Pai-88/emg-robotic-hand/docs/electronics_setup.html

# EMG → Robotic Hand · Electronic Setup

Dual-channel surface EMG · ESP32 acquires at 1 kHz · UDP/WiFi → Pi 5 inference → PCA9685 → 5-finger servo hand

3.3 V power

Ground

CH 1 · flexor signal

CH 2 · extensor signal

Leads-off (digital)

WiFi (UDP)

I²C

PWM (servo)

AD8232 #1 (flexor) → ESP32

AD8232 pin | ESP32 pin | Signal
3.3V | 3V3 | power
GND | GND | ground
OUTPUT | GPIO 34 | analog (flexor)
LO+ | GPIO 25 | leads-off (+)
LO− | GPIO 27 | leads-off (−)
RA | — | flexor electrode +
LA | — | flexor electrode −
RL | — | reference (shared with #2)

AD8232 #2 (extensor) → ESP32

AD8232 pin | ESP32 pin | Signal
3.3V | 3V3 | power (shared)
GND | GND | ground (shared)
OUTPUT | GPIO 35 | analog (extensor)
LO+ | GPIO 26 | leads-off (+)
LO− | GPIO 32 | leads-off (−)
RA | — | extensor electrode +
LA | — | extensor electrode −
RL | — | reference (same electrode as #1)

⚠ Servo power: Drive the PCA9685's V+ from a separate 5–6 V supply (e.g. UBEC, bench PSU, or fresh 4× AA pack), with its GND tied to the Pi's GND. Do not power servos from the Pi's 5 V rail — typical hobby-servo stall current (~1 A each, ×5) will brown out the Pi and risk corrupting the SD card.

Pin assignments mirror esp32_emg_streamer.ino (the active dual-channel UDP firmware). Edit it (or this diagram) in lockstep if you reassign pins. Sampling: 1 kHz × 2 ch, packet size 48 bytes.
