Pai-88/emg-robotic-hand/kicad/emg_frontend.pdf

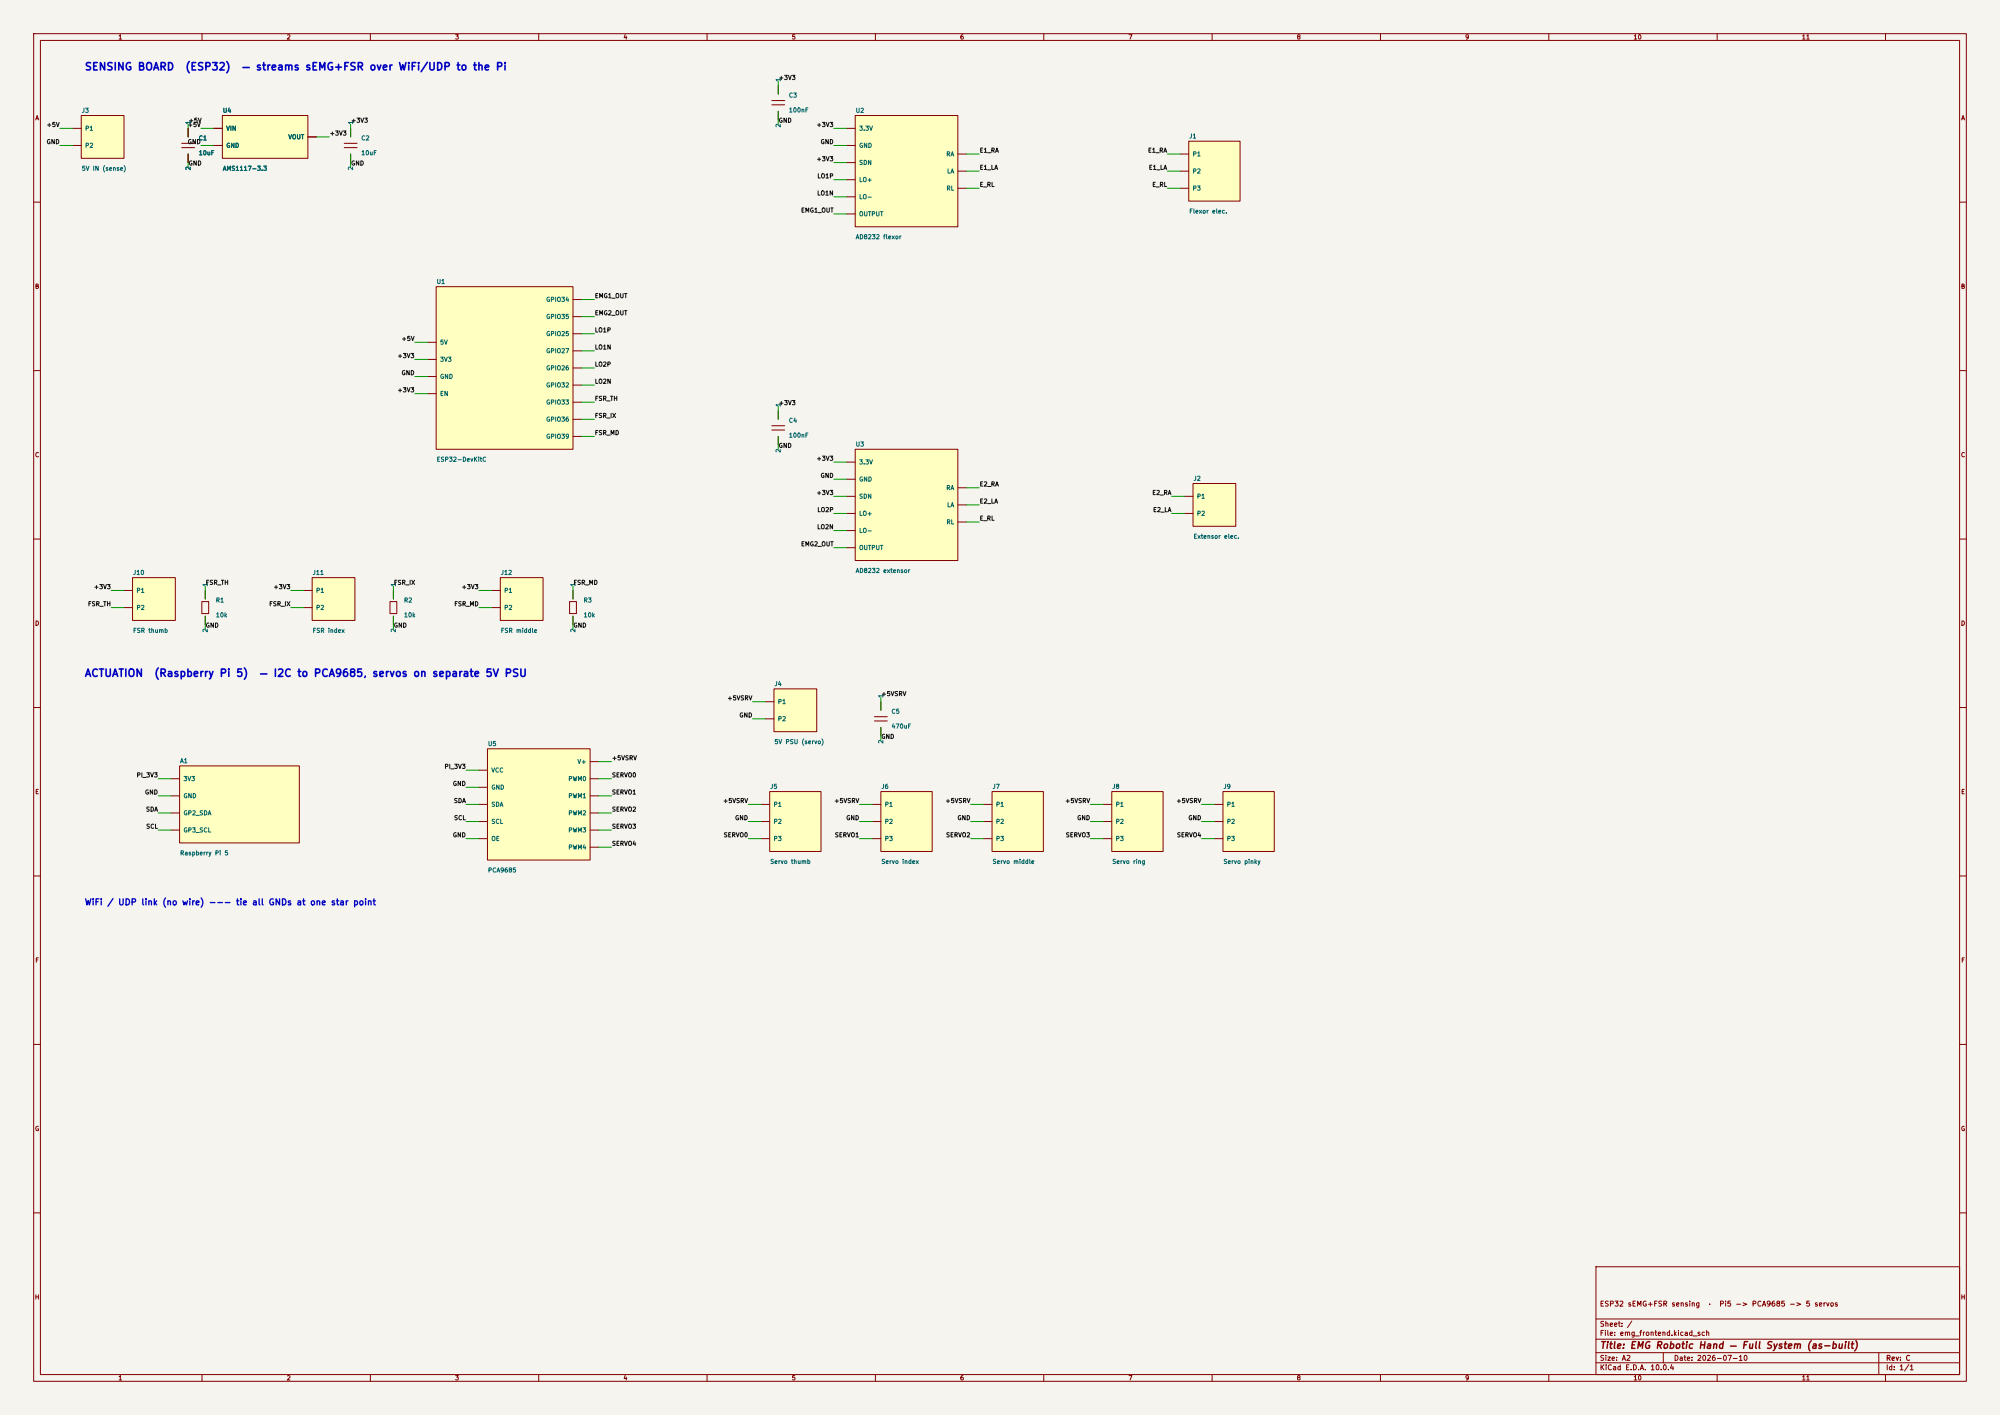
[picture p1: page 1]

SENSING BOARD (ESP32) — streams sEMG+FSR over WiFi/UDP to the Pi C1

FSR_IX ACTUATION (Raspberry Pi 5) — I2C to PCA9685, servos on separate 5V PSU

WiFi / UDP link (no wire) --- tie all GNDs at one star point

ESP32 sEMG+FSR sensing · Pi5 -> PCA9685 -> 5 servos

Sheet: /
File: emg_frontend.kicad_sch
Title: EMG Robotic Hand — Full System (as-built)

Size: A2 | Rev: C
KiCad E.D.A. 10.0.4 | Id: 1/1
