Pai-88/emg-robotic-hand/kicad/emg_frontend.kicad_sch

## KiCad design kicad/emg_frontend.kicad_sch (2026-07-14)

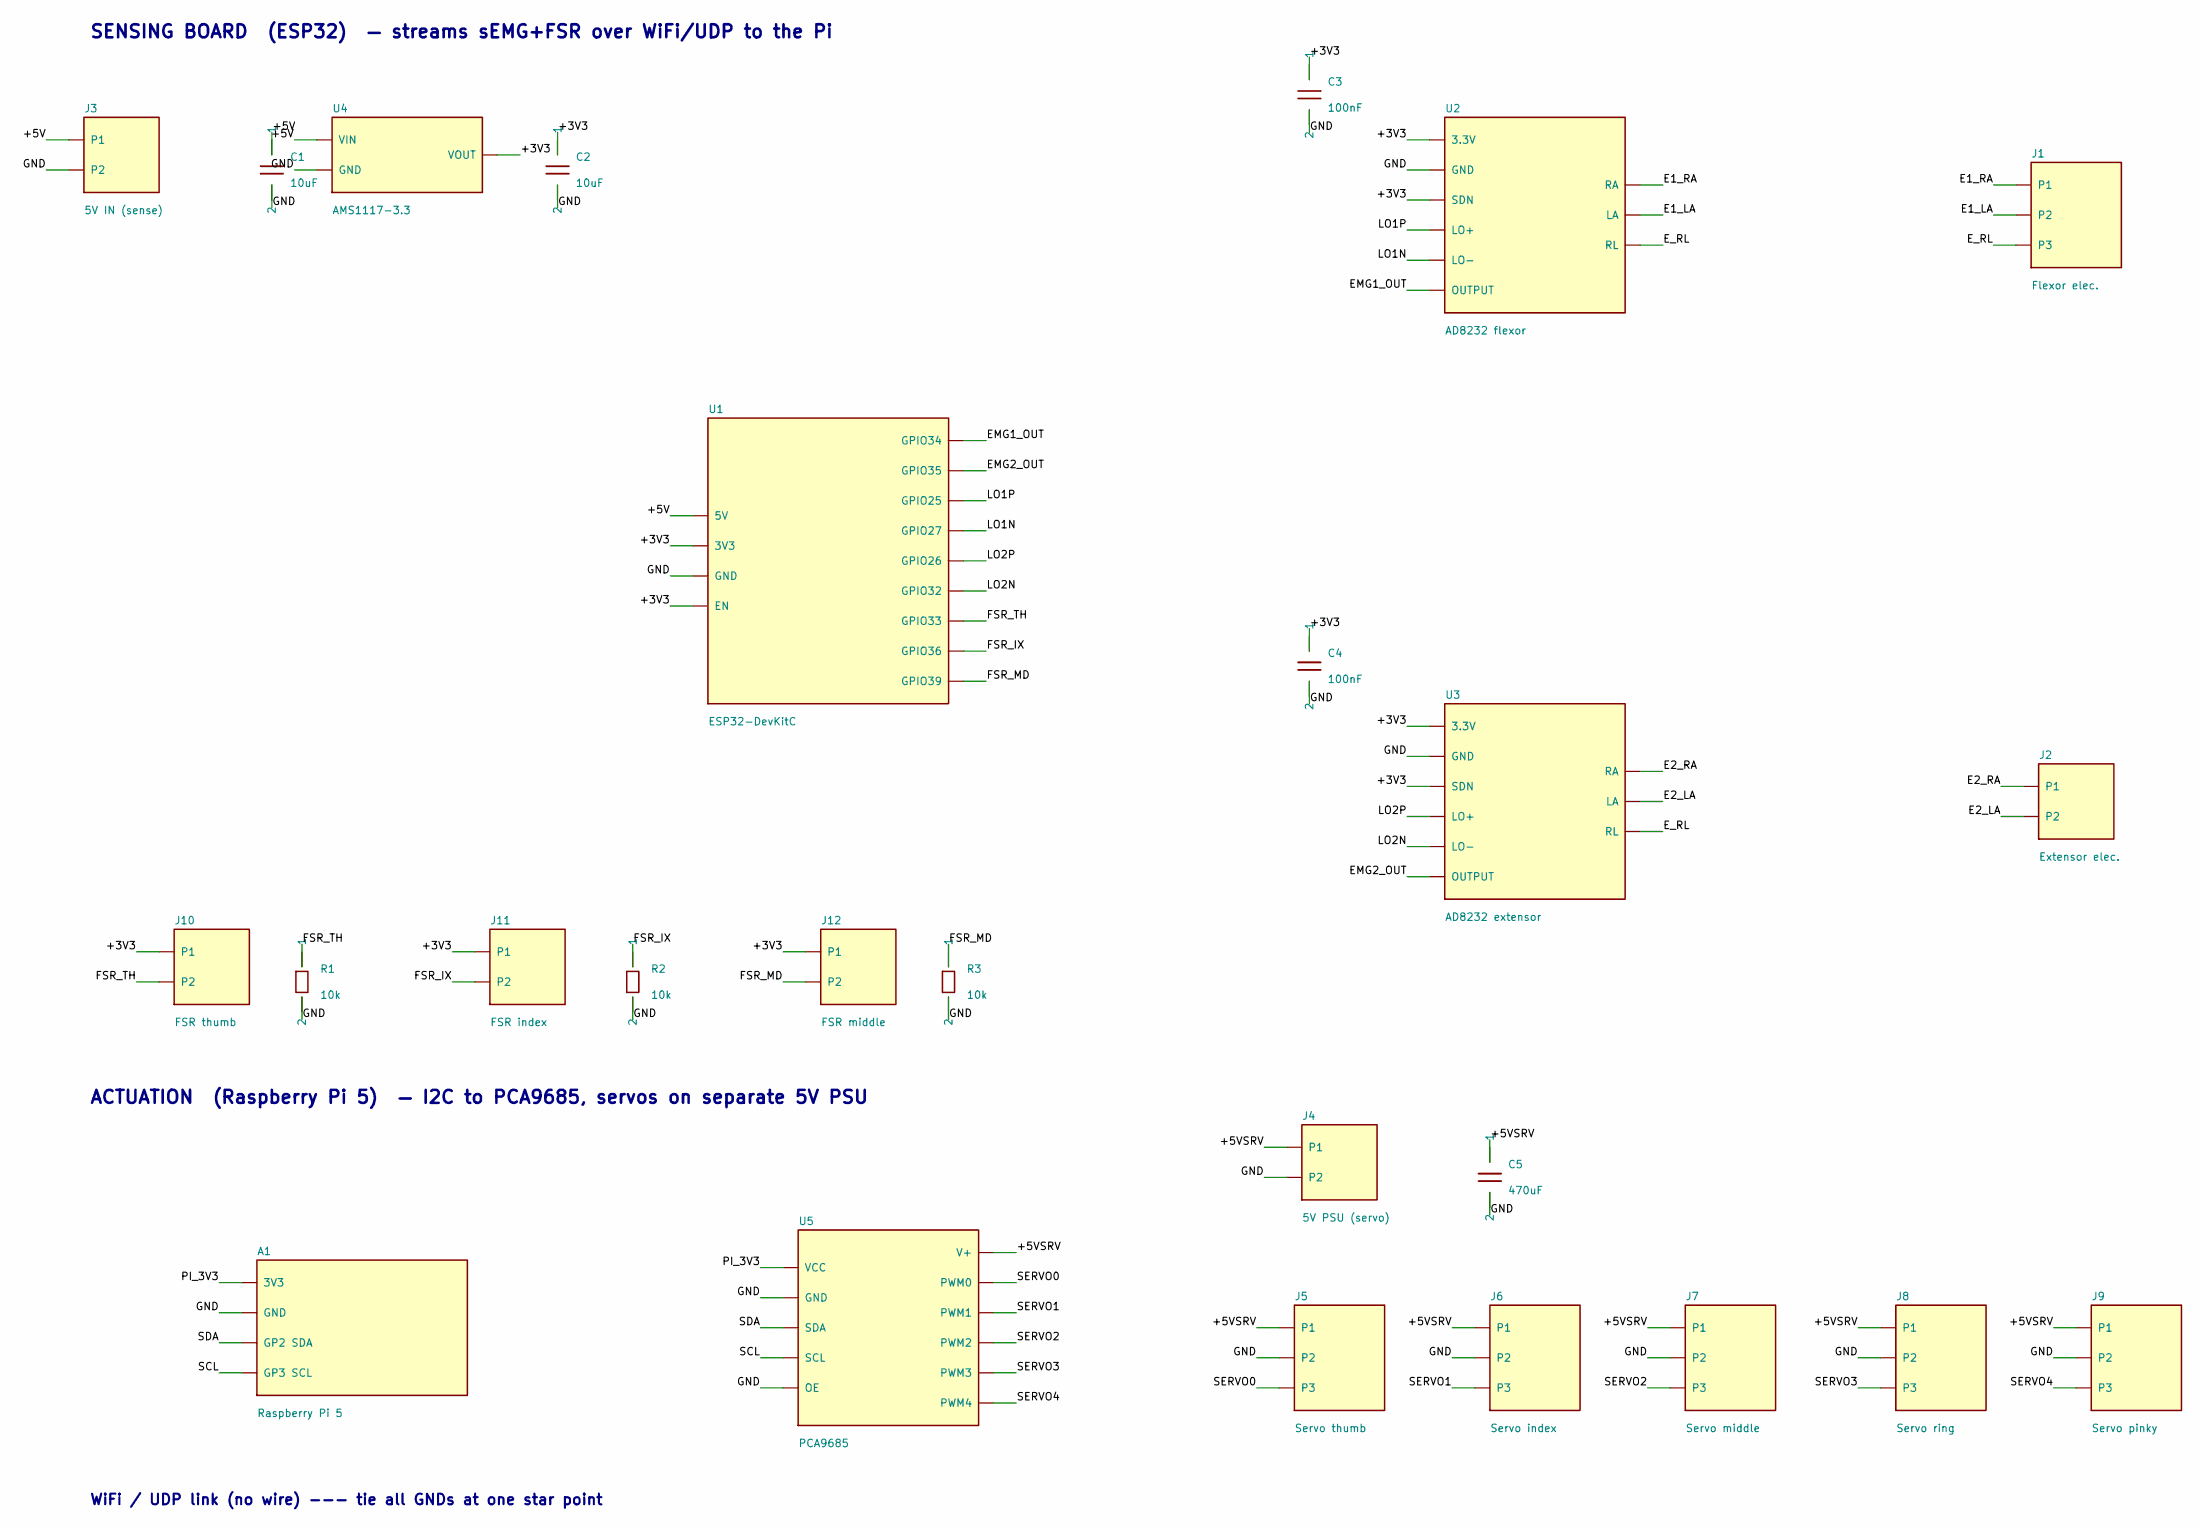
[picture p2: schematic emg_frontend.kicad_sch]

Parts:
A1: Raspberry Pi 5; PinHeader_2x20_P2.54mm_Vertical
C1, C2: 10uF; C_1206_3216Metric
C3, C4: 100nF; C_0805_2012Metric
C5: 470uF; CP_Radial_D8.0mm_P3.50mm
J1: Flexor elec.; PinHeader_1x03_P2.54mm_Vertical
J2: Extensor elec.; PinHeader_1x02_P2.54mm_Vertical
J3: 5V IN (sense); TerminalBlock_MaiXu_MX126-5.0-02P_1x02_P5.00mm
J4: 5V PSU (servo); TerminalBlock_MaiXu_MX126-5.0-02P_1x02_P5.00mm
J5: Servo thumb; PinHeader_1x03_P2.54mm_Vertical
J6: Servo index; PinHeader_1x03_P2.54mm_Vertical
J7: Servo middle; PinHeader_1x03_P2.54mm_Vertical
J8: Servo ring; PinHeader_1x03_P2.54mm_Vertical
J9: Servo pinky; PinHeader_1x03_P2.54mm_Vertical
J10: FSR thumb; PinHeader_1x02_P2.54mm_Vertical
J11: FSR index; PinHeader_1x02_P2.54mm_Vertical
J12: FSR middle; PinHeader_1x02_P2.54mm_Vertical
R1, R2, R3: 10k; R_0805_2012Metric
U1: ESP32-DevKitC; PinHeader_2x19_P2.54mm_Vertical
U2: AD8232 flexor; PinHeader_1x10_P2.54mm_Vertical
U3: AD8232 extensor; PinHeader_1x10_P2.54mm_Vertical
U4: AMS1117-3.3; SOT-223-3_TabPin2
U5: PCA9685; PinHeader_2x06_P2.54mm_Vertical

Connections:
+3V3: C2.1, C3.1, C4.1, J10.1, J11.1, J12.1, U1.2 (3V3), U1.4 (EN), U2.1 (3.3V), U2.3 (SDN), U3.1 (3.3V), U3.3 (SDN), U4.3 (VOUT)
+5V: C1.1, J3.1, U1.1 (5V), U4.1 (VIN)
+5VSRV: C5.1, J4.1, J5.1, J6.1, J7.1, J8.1, J9.1, U5.6 (V+)
E1_LA: J1.2, U2.8 (LA)
E1_RA: J1.1, U2.7 (RA)
E2_LA: J2.2, U3.8 (LA)
E2_RA: J2.1, U3.7 (RA)
EMG1_OUT: U1.5 (GPIO34), U2.6 (OUTPUT)
EMG2_OUT: U1.6 (GPIO35), U3.6 (OUTPUT)
E_RL: J1.3, U2.9 (RL), U3.9 (RL)
FSR_IX: J11.2, R2.1, U1.12 (GPIO36)
FSR_MD: J12.2, R3.1, U1.13 (GPIO39)
FSR_TH: J10.2, R1.1, U1.11 (GPIO33)
GND: A1.2 (GND), C1.2, C2.2, C3.2, C4.2, C5.2, J3.2, J4.2, J5.2, J6.2, J7.2, J8.2, J9.2, R1.2, R2.2, R3.2, U1.3 (GND), U2.2 (GND), U3.2 (GND), U4.2 (GND), U5.2 (GND), U5.5 (OE)
LO1N: U1.8 (GPIO27), U2.5 (LO-)
LO1P: U1.7 (GPIO25), U2.4 (LO+)
LO2N: U1.10 (GPIO32), U3.5 (LO-)
LO2P: U1.9 (GPIO26), U3.4 (LO+)
PI_3V3: A1.1 (3V3), U5.1 (VCC)
SCL: A1.4 (GP3 SCL), U5.4 (SCL)
SDA: A1.3 (GP2 SDA), U5.3 (SDA)
SERVO0: J5.3, U5.7 (PWM0)
SERVO1: J6.3, U5.8 (PWM1)
SERVO2: J7.3, U5.9 (PWM2)
SERVO3: J8.3, U5.10 (PWM3)
SERVO4: J9.3, U5.11 (PWM4)

Notes on the sheet:
SENSING BOARD (ESP32) — streams sEMG+FSR over WiFi/UDP to the Pi
ACTUATION (Raspberry Pi 5) — I2C to PCA9685, servos on separate 5V PSU
WiFi / UDP link (no wire) --- tie all GNDs at one star point
